kotachang/UBCSubbots/README.md

# UBCSubbots (Electrical Team)
Git repository for the newspaper eating contest 2x back to back champions.

Going for the three-peat!
