kotachang/UBCSubbots/current_2019_20_subbots/PCB/Battery_Monitor/BMS.pdf

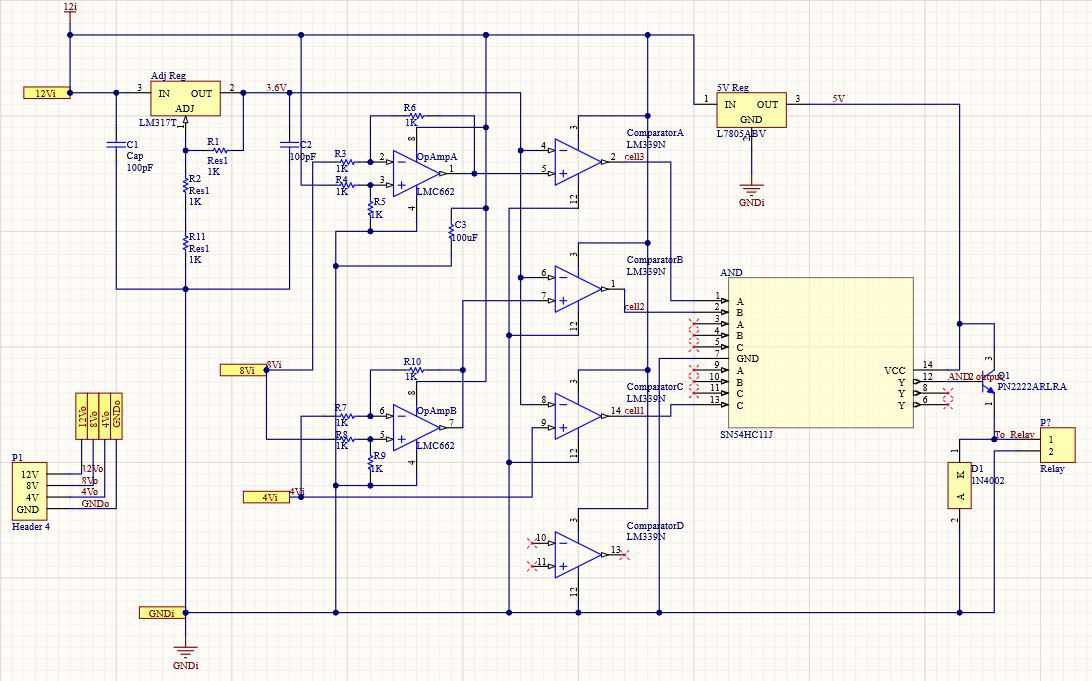
[picture p8: page 1]
