kotachang/UBCSubbots/current_2019_20_subbots/PCB/Battery_Monitor/Rough Size Estimate.JPG

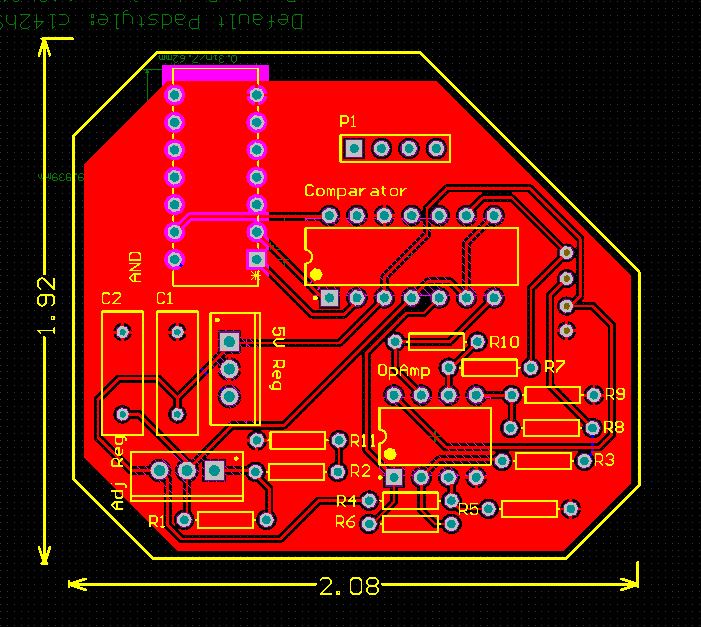
current_2019_20_subbots/PCB/Battery_Monitor/Rough Size Estimate.JPG
