kotachang/UBCSubbots/Subbots_2018_19/Thruster System/images/PCA9685_pinout.png

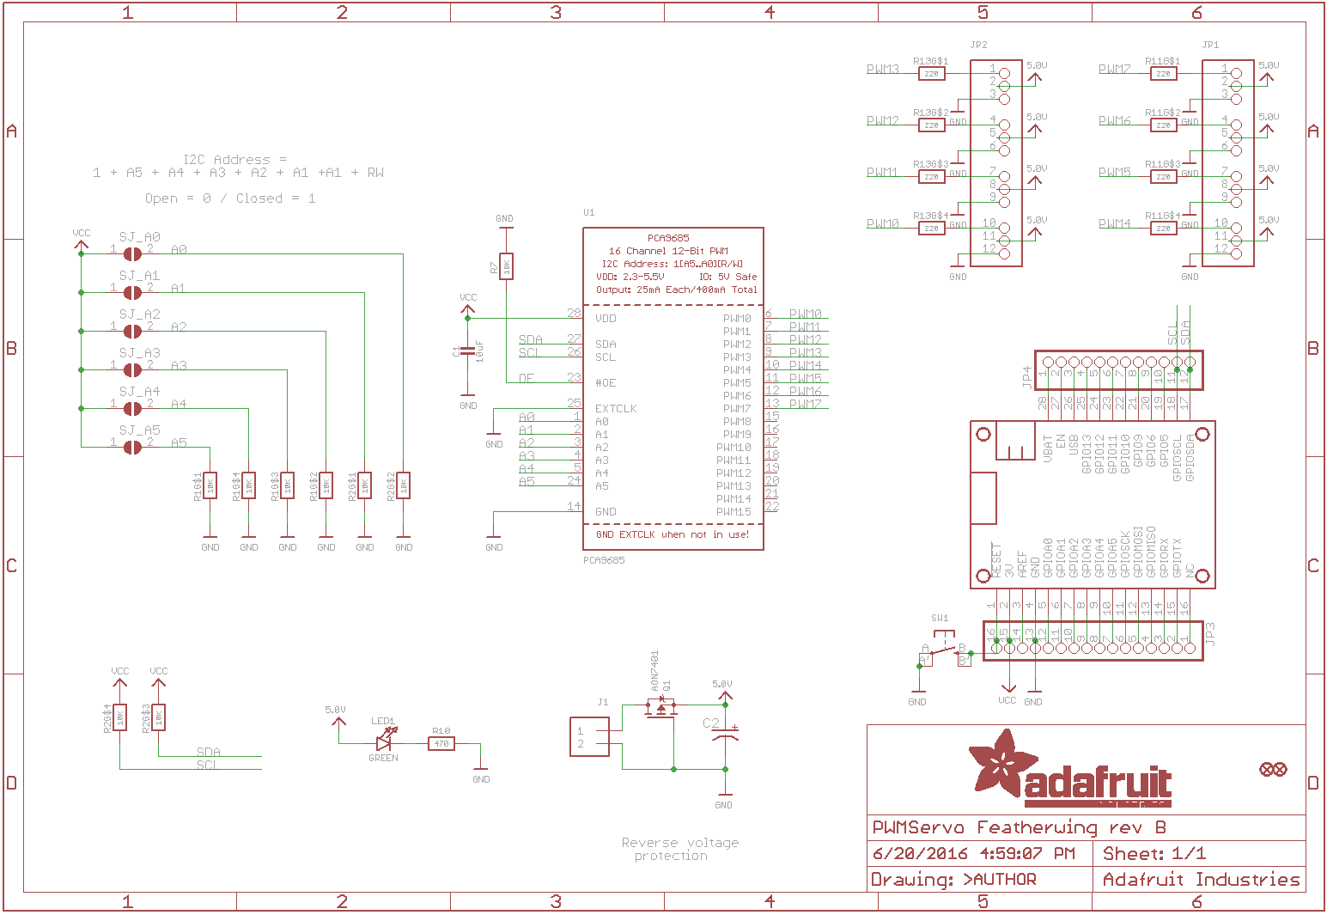
Subbots_2018_19/Thruster System/images/PCA9685_pinout.png
