kotachang/UBCSubbots/Subbots_2018_19/Power Distribution/Power Distribution Schematic.pdf

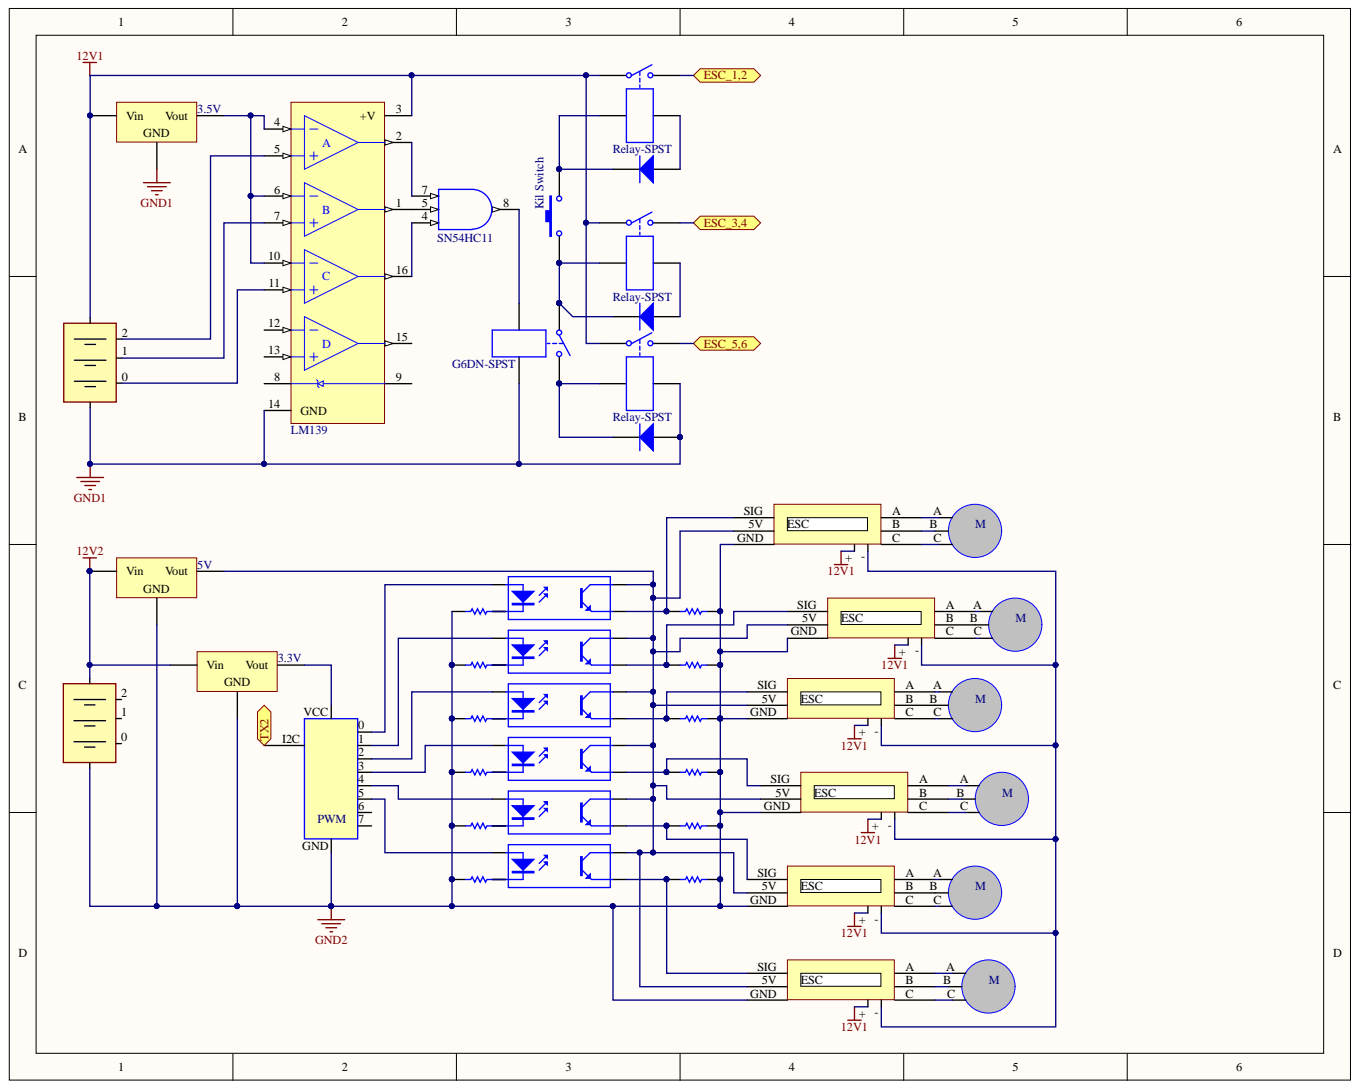
[picture p13: page 1]

GND1 | 6
