kotachang/UBCSubbots/(list of files, drawings)

Other design files:
current_2019_20_subbots/PCB/Battery_Monitor/Battery_Monitor.pcbdoc
current_2019_20_subbots/PCB/Battery_Monitor/Battery_Monitor.PrjPcb
current_2019_20_subbots/PCB/Battery_Monitor/Battery_Monitor.schdoc
current_2019_20_subbots/PCB/Battery_Monitor_4Cell/Battery_Monitor_4Cell.PcbDoc
current_2019_20_subbots/PCB/Battery_Monitor_4Cell/Battery_Monitor_4Cell.pcbdoc
current_2019_20_subbots/PCB/Battery_Monitor_4Cell/Battery_Monitor_4Cell.PrjPcb
current_2019_20_subbots/PCB/Battery_Monitor_4Cell/Battery_Monitor_4Cell.schdoc
current_2019_20_subbots/thruster_system/PCB/Opto_PCB_v1.PcbDoc
current_2019_20_subbots/thruster_system/PCB/Optocoupler_circuit.PrjPCB
current_2019_20_subbots/thruster_system/PCB/Optocoupler_circuit.SchDoc
