kotachang/UBCSubbots/(commit log)

2019-02-09 Power distribution circuit upload
    -not tested
2019-02-16 camera calibration files and readme
2019-02-23 add PWM files
2019-02-23 update and clean README for camera calibration
2019-02-23 create readme for PWM
2019-02-23 rename schematic file to something understandable
2019-02-26 Pwm minor changes (#3)
    * Readme Modifications
    * capitalize extension
    * mas
2019-03-02 added in leak sensor read me (#5)
2019-03-02 Pwm minor changes (#3)
    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
2019-03-02 update readme to include 'camera model'
2019-03-07 added cylinder calibration
2019-03-09 Pressure Sensor
2019-03-09 add motor initialization
2019-03-31 add thruster files
2019-05-11 Rename Battery Monitor Circuit Writeup to Battery Monitor Circuit Writeup.txt
2019-10-26 Added serial_control_esc.ino which allows a user to control a blue-robotics motor via arduino PWM over the serial monitor. Also added some notes about the optocoupler's (MCT6) rise and fall time with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
2019-11-02 Added modified Servo Library for optocoupler inversion
2020-01-18 Pressure sensor off-the shelf code, needs to be integrated into ESC control
2020-01-19 Rename Pressure Sensor README.md to README.md
2020-01-19 image folder in pressure sensor
2020-02-03 modified output files to work with Osh Park
    [Battery_Monitor.GBL, Battery_Monitor.GBO, Battery_Monitor.GBP, Battery_Monitor.GBS, Battery_Monitor.GKO, Battery_Monitor.GM1, Battery_Monitor.GTL, Battery_Monitor.GTO]
2020-02-09 added battery monitor pdf to files
2020-03-01 Changed Servo library so that the PWM signal is inverted for all servo Pins, and included tested example of 6 servos at once
    [Servo.cpp, multiple_motors_serial_control.ino]
2020-03-07 Add routing to PCB
    [Battery_Monitor_4Cell.PcbDoc]
2020-03-07 Add updated 4 cell schematic
    [Battery_Monitor_4Cell.schdoc]
2020-03-12 updated 3S battery monitor with pullup resister and hole dimensions
    [Battery_Monitor.PrjPcb, Battery_Monitor.pcbdoc, Battery_Monitor.schdoc, Battery_Monitor_4Cell.pcbdoc]
2020-03-13 4S PCB done
    [Battery_Monitor_4Cell.GBL, Battery_Monitor_4Cell.GBO, Battery_Monitor_4Cell.GBP, Battery_Monitor_4Cell.GBS, Battery_Monitor_4Cell.GKO, Battery_Monitor_4Cell.GM1, Battery_Monitor_4Cell.GTL, Battery_Monitor_4Cell.GTO]
2020-03-13 4S fabrication outputs modified, complete
    [Battery_Monitor_4Cell.PrjPcb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]
2020-03-13 finished output files for fixed 3S BMS PCB
2020-03-14 res vals for adj. regulator updated
2020-03-15 Optocoupler PCB circuit routed, but needs some tuning
    [Opto_PCB_v1.PcbDoc, Optocoupler_circuit.PrjPCB, Optocoupler_circuit.SchDoc]
2020-03-17 made edites to optocoupler pcb, updated resistor values for 3s battery monitor pcb
    [Battery_Monitor.schdoc, Battery_Monitor_4Cell.schdoc, Opto_PCB_v1.PcbDoc, Optocoupler_circuit.PrjPCB, Optocoupler_circuit.SchDoc]
2020-03-17 added some silk screen polarity indicators on motor mounts and waived mounting hole and silk screen related DRC violations
    [Opto_PCB_v1.PcbDoc, Optocoupler_circuit.PrjPCB]
2020-03-18 fabrication outputs made
    [Opto_PCB_v1.GBL, Opto_PCB_v1.GBO, Opto_PCB_v1.GBP, Opto_PCB_v1.GBS, Opto_PCB_v1.GKO, Opto_PCB_v1.GTL, Opto_PCB_v1.GTO, Opto_PCB_v1.GTP]
